notmasteryet/SatPointer/README.md

# SatPointer

Shows where the board is pointing, in the terms used to aim a satellite dish,
and tells you which way to turn to reach a target you dial in.

- **azimuth**: true bearing, 0° = north, 90° = east, measured clockwise
- **elevation**: angle above the horizon, from −90° to +90°
- **roll**: rotation around the pointing direction

The pointing direction is the beam, which is whichever device axis the
**beam mount** setting names — by default the +X arrow printed on the GY-521.

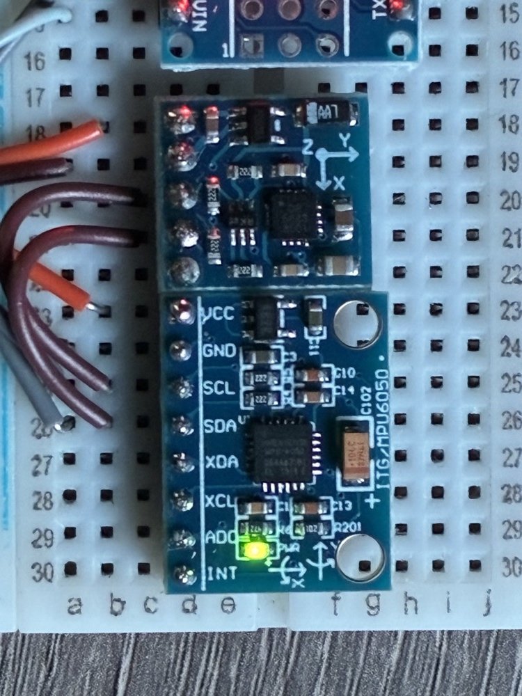
[picture p1: images/board.jpg]
board


Ported from the Arduino Nano sketch in `docs/original-nano/` to an
ESP-12F with an OLED and a rotary encoder. The sensor maths is unchanged.

## Hardware

| Part | Chip | I2C address |
|---|---|---|
| ESP-12F on a USB-UART adapter | ESP8266EX, 4MB flash | |
| GY-521 | MPU6050 (accelerometer) | 0x68 |
| GY-271 | QMC5883L (magnetometer) | 0x0D |
| 0.96" OLED | SSD1306 128×64 | 0x3C |
| EC11 rotary encoder + button | | |

All three I2C devices share one bus:

| Signal | ESP-12F |
|---|---|
| SDA | GPIO4 |
| SCL | GPIO5 |
| VCC | **3.3V** |
| GND | GND |

| Encoder | ESP-12F |
|---|---|
| A | GPIO13 |
| B | GPIO14 |
| button | GPIO0 |
| common (middle pin of the 3-pin side) | GND |

The quadrature section and the push switch have **separate grounds**. With the
common pin floating the button still works perfectly while the dial does
nothing at all, because the internal pullups hold A and B high and no edge ever
reaches the interrupt. Send `e` to check: if A and B do not change as you turn,
that is the cause. On a KY-040 breakout, its **+** pin must also be powered,
since its pullups are on the module.

**The ESP8266 is not 5V tolerant.** The original Nano wiring ran both sensor
modules from 5V; on this board they must be on 3.3V.

**GPIO0 is the boot strapping pin.** Holding the encoder button down through a
reset enters the flash bootloader instead of the app — which is convenient, it
doubles as a proper flash button, but it means the button must idle high.

Boot pins on the bare module: EN (CH_PD) → 3.3V, GPIO15 → GND, GPIO2 floating.
Use a 3.3V adapter that can source ~300mA peak; cheap breakouts brown out
mid-flash.

**Sensor mounting:** both sensor modules lie flat on the board, with the
GY-271's **Y** arrow pointing the same way as the GY-521's **X** arrow. That
relationship is fixed in `ACC_AXIS` / `MAG_AXIS` in `src/orientation.cpp`;
change it only if you rearrange the modules relative to each other.

**Beam mounting** — which way round the whole device clamps to the beam — is a
runtime setting, see below.

Some GY-271 boards carry an HMC5883L (0x1E) or a QMC5883P (0x2C) instead, which
this code does not support. The I2C scan printed at every boot names whichever
is fitted and flags anything unexpected on the bus.

## Beam mount

The beam points along one of four device axes. Press `m` to cycle; the current
one shows in the status row and in `p` output.

| Mount | Beam axis | Beam points out the device's |
|---|---|---|
| `top` | +X | top face (default) |
| `left` | +Y | left side |
| `right` | −Y | right side |
| `away` | −Z | back, away from the screen |

Axes are the board frame: X = the GY-521's printed +X arrow, Y = left, Z = up.

**This table was measured, not inferred.** Holding the device with its top face
at true north and the screen up, the `a` command reported +X north, +Y west, −Y
east and −Z straight down. An earlier version was worked out from how the board
looked and had three of the four entries wrong — if you rebuild the hardware,
re-measure it with `a` rather than reasoning about it.

**Changing the mount means recalibrating.** Hard/soft-iron correction is in
sensor frame and survives moving the sensor relative to itself, but clamping to
a different face of a metal beam changes the surrounding ferrous mass entirely.

## Build and flash

```sh
pio run -t upload                 # flash over serial (needs GPIO0 held low)
pio run -e ota -t upload          # flash over WiFi, no cable and no button
python3 tools/monitor.py          # serial capture (clears DTR; see below)
```

Once WiFi is configured, use the OTA target — serial flashing on this hardware
means holding the encoder button down through every upload.

Source layout:

| File | Holds |
|---|---|
| `main.cpp` | setup/loop, sample and draw scheduling |
| `config.h` | pins, addresses, timing constants |
| `sensors.*` | I2C bus, MPU6050 and QMC5883L reads, boot scan |
| `orientation.*` | mount table, frame remap, sensor fusion |
| `calibration.*` | magnetometer min/max calibration |
| `display.*` | SSD1306 rendering |
| `input.*` | encoder and button |
| `commands.*` | serial commands and the data line |
| `rotator.*` | declares the SatNOGS rotator's position from this aim |
| `settings.*` | the persisted `Settings` struct |

`upload_port` is pinned in `platformio.ini`. For a 0.91" panel change
`-D OLED_H=64` to `32`.

If an upload fails with `Timed out waiting for packet header`, hold the encoder
button (or ground GPIO0) while the board resets, upload, then release it.

## Use

The display has two screens, swapped from the menu under **Screen**.

The graphic one is the default: a compass seen from above and the same beam
seen from the side, each drawn as an arm with the device as a crossbar on it,
plus an arrowhead for which way to turn. The yellow strip along the top carries
how far to go, the current angles, and whether the calibration can be trusted.

`tools/simulate/run.sh` renders that screen on a host by compiling the real
`src/guidance.cpp` against a mock Adafruit_GFX. Use it when changing the
layout — the panel is two-colour, the top 16 rows being yellow and the rest
cyan with a gap between, so nothing may straddle row 16, and that is far easier
to check in a terminal than by flashing and squinting.

The numeric screen shows current and target angles, and what to do about the
difference:

```
AZ  90.2 -> 145.0
EL  -1.5 ->  28.5
--------------------
turn RIGHT     54.8
raise          30.0

[AZ]  el     cal ok
```

- **turn the encoder** to move the target
- **press** to switch between editing azimuth and elevation — the bracketed
  label shows which is live
- **hold** for 0.8s to open the menu

## Menu

Hold the button to open it, turn to choose, press to activate, hold to go back.

| Item | Does |
|---|---|
| Rotor north | tells the SatNOGS rotator where its antenna points — see below |
| Mount | pick the beam mount; turn to preview, press to apply, hold to cancel |
| WiFi | shows link state and address; press toggles the radio |
| Screen | graphic or numbers |
| Clear target | zeroes both targets |
| Calibrate | starts magnetometer calibration — press to save, hold to abandon. The verdict (OK / POOR / FAILED, with the score) shows on screen afterwards. |
| Exit | back to the guidance screen |

Five items fit on the panel; the list scrolls to follow the selection.

### Rotor north

Clamp the device to the antenna boom on the SatNOGS rotator, open **Rotor
north**, and press. It connects to `satnogs-rotor1:23` (esp-link's serial
bridge, `ROTATOR_HOST` in `config.h`) and does what `sattrack.py deploy` does,
with the pointer's reading standing in for sighting the sun:

```
M114                       what the rotator thought before, shown as "was"
M503, M564 E               which way its E axis is set; flipped if it does not match
G92 A<az> E<-el>           this is where the antenna points
M208 S1 A<az-360> ...      travel re-centred a turn either way
M208 S0 A<az+360> ...
M500                       saved
M114                       confirmed: Ref:11 and A took
```

**Turn the dial to pick the antenna side, CW or CCW.** The antenna can be
bolted to either end of the elevation shaft, and on the far end it faces the
other way, so the same rotation lowers it instead of raising it. CW is the
side the rotator was built for (`M562 E1`). CCW makes Rotor north send
`M564 E`, which inverts the rotator's E axis and is saved by the `M500`, but
only when the rotator is set for the other side. Negative E then means up on
either side, so `tracker/config.json`'s `el_sign` stays −1. The 180° of
azimuth that come with the far side need nothing, because the declaration is
the pointer's reading of where the antenna really points.

Nothing moves, and the motors stay as they were. Elevation is declared too,
since one aim pins both and the accelerometer's elevation is the reading to
trust. `E` is sky elevation times −1, the build's `el_sign`.

- The declared A is the bearing's equivalent nearest the rotator's current
  count (−21, not 339), so "go north" afterwards is the short way round.
- **Have the cable wrap neutral first.** The travel fence is a wrap budget
  around the declared position, as `deploy` treats it.
- **Don't run `sattrack.py` at the same time.** esp-link sends every reply to
  every connection.
- Azimuth is only as good as the calibration, so the screen shows the grade
  before you press. Calibrate with the device on the boom, since the antenna's
  metal moves with it.

The mount picker previews without committing, so turning past the one you want
costs nothing. Applying a mount resets the sensor filter and warns that the
magnetometer calibration no longer holds.

Calibration is the same whether started from the menu or by sending `c`, so
either can finish it.

The target is saved to EEPROM two seconds after you stop turning, so a sweep of
the dial costs one flash write rather than one per detent.

Serial at **115200** prints 10 lines per second, as `label:value` pairs so the
Serial Plotter can graph them:

```
elev:-1.5 az:90.2 daz:54.8 del:30.0 roll:0.8 dip:65.3 B:52.1
```

| Field | Meaning |
|---|---|
| `elev` | elevation of the beam |
| `az` | true azimuth of the beam |
| `daz` | degrees to turn to reach the target; positive = clockwise |
| `del` | degrees to raise to reach the target |
| `roll` | rotation around the beam; positive when the right side is down. This is dish skew. |
| `dip` | magnetic dip angle. Should hold constant while the device is still; if it moves when it is not being handled, the axis mapping is off. |
| `B` | field strength in µT. Earth's is 25–65; much more means something magnetic is nearby. |

## Network

On first boot with no stored credentials the device brings up an open access
point, **SatPointer-setup**. Join it, open any address in a browser, and enter
your network and password; it saves them and reboots. Or set them over serial
with `w<ssid> <password>`.

Once joined it is `satpointer.local`, and `pio run -e ota -t upload` flashes it
wirelessly. If the stored credentials stop working it falls back to the setup
AP rather than retrying forever — otherwise there would be no way to correct
them without a cable.

The radio can be switched off from the menu, or with `W` over serial.
**Measured 2026-09-24, it does not need to be:** field noise with the radio
off, idle, and under load was sd 0.091, 0.094 and 0.090 uT, with azimuth sd
0.54–0.55 throughout — no detectable interference. The toggle stays because
that result is specific to this layout; re-measure with `W` if the
magnetometer moves closer to the module.

OTA has no password, so anyone on the network can reflash the device. That is
usually fine on a home LAN; if it is not, set one with
`ArduinoOTA.setPassword()` in `src/net.cpp` and add `upload_flags` to the `ota`
environment.

## gpredict

The device emulates hamlib's **rotctld on TCP 4533**, which gpredict drives
natively. You are the rotator: gpredict sends where to point, reads back where
the device actually points, and you turn the dish by hand following the
display. A `NET` marker appears on screen while it is driving, so the targets
moving on their own is not alarming.

In gpredict, add a rotator with host `satpointer.local` and port `4533`.

| Command | Reply |
|---|---|
| `p` / `\get_pos` | azimuth and elevation, one per line |
| `P az el` / `\set_pos az el` | `RPRT 0` |
| `S` stop, `K` park | `RPRT 0` — nothing to stop, but refusing would look like a fault |
| `_` | `SatPointer` |
| anything else | `RPRT -1`, and logged to serial |

Targets set over the network are **not** written to flash. gpredict sends `P`
about once a second for the length of a pass, which through the encoder's save
path would be thousands of flash writes.

### Radio frequency — rigctld on TCP 4532

It also emulates **rigctld on TCP 4532**, where gpredict's radio controller
connects, so the frequency gpredict tunes to, Doppler included, is shown on the
display. There is no radio behind it. In gpredict, add a radio with host
`satpointer.local` and port `4532`.

The frequency takes the top-right slot that otherwise shows calibration status
(bottom-right on the numbers screen), in MHz with as many decimals as fit:
trailing zeros dropped: `145.89`, `145.8123`, `10489.55`. It is the main VFO (VFO A), which is the downlink in
every gpredict mode except a TX-only radio. It clears when gpredict disconnects.

`F`/`f` frequency, `V`/`v` VFO, `I`/`i` split TX frequency, `S`/`s` split,
`M`/`m` mode, `T`/`t` PTT (always off), `\get_dcd`, `\chk_vfo`, with their long
forms. Reads return what was set, which is what gpredict checks to tell whether
the knob was turned. Anything else is answered `RPRT -1` and logged to serial
as `# rigctl: unhandled '...'`. `/status` shows the current frequency.

## Config page

`http://satpointer.local` is where the fiddly settings live, rather than on a
128x64 panel behind one knob. Live azimuth and elevation with which way to
turn, the target, beam mount, azimuth trim, calibration with live coverage bars
and its graded verdict, WiFi credentials, radio toggle, and erase.

The device keeps the target dial and the guidance screen; the browser gets
everything else. Serial commands still work and are the fallback when there is
no network.

Two other endpoints: `/status` is plain text for shells and scripts, `/api` is
JSON and is what the page polls.

## Calibration (do once)

The magnetometer needs calibrating, because the module headers and anything
steel nearby bend the magnetic field. Do it with everything mounted exactly as
it will be used. Until it is done the display shows **NO CAL** and azimuth
should not be trusted.

1. **Magnetometer:** menu → Calibrate (or send `c`), slowly rotate the board
   through *every* orientation for 30–60 seconds including upside down, then
   press (or send `c` again). The display shows the swing collected on each
   axis and the sample count while this runs.

   **Calibrate in the exact final configuration, cables included.** Hard-iron
   offsets belong to the surrounding metal, so a calibration done with the UART
   unplugged does not transfer to running with it plugged in.

   The result is graded, not assumed. The device applies the fit back to the
   samples it kept and measures how constant the corrected field magnitude
   comes out; Earth's field is locally constant, so any remaining variation is
   fit error. Under 3% standard deviation counts as calibrated and the status
   slot reads `ok N%`; above it reads `BAD N%` and azimuth is not trusted.

   |B| is used rather than dip because dip also needs the accelerometer's idea
   of down, so handling acceleration corrupts it and it cannot tell a bad fit
   from someone waving the device about.
2. **North:** point the beam at a known true bearing and send it. `n90`
   means it points east, `n` means north. This also absorbs magnetic
   declination.

Both are saved to EEPROM and survive a restart.

| Command | Action |
|---|---|
| `c` | start / finish magnetometer calibration |
| `x` | abandon a calibration in progress |
| `nDEG` | the beam is currently pointing at true bearing DEG |
| `m` | cycle the beam mount (top / left / right / down) |
| `r` | switch raw sensor output on or off |
| `e` | print encoder pin states, for the wiring check above |
| `a` | print where every board axis is pointing, for filling in the mount table |
| `w<ssid> <pass>` | store WiFi credentials |
| `p` | print stored settings |
| `z` | erase settings |
| `h` | help |

## How it works

At rest, the accelerometer tells which way is down (**D**), and the
magnetometer gives the magnetic field (**M**). From those two vectors:

- **East** = D × M
- **North** = East × D

Taking the beam's components along north, east and down gives azimuth
`atan2(E, N)` and elevation `asin(−D)`. This works however the board is tilted.
Both sensor vectors are smoothed with a simple low-pass filter.

## Status

Verified on hardware 2026-09-22: both sensors read (field 46 µT, well inside
Earth's range), EEPROM load/store works, the encoder counts and its target
persists, and the button toggles the edited axis cleanly.

Phase-1 refactor and beam mount verified on hardware 2026-09-23: all four
mounts produce the angles geometry requires (beam reversed flips elevation and
swings azimuth 180°, the side face reads ~0° elevation and 90° round, the
bottom face reads 90° below the front), cycling returns to the start value, and
dip and field strength — both rotation invariants — hold constant across all
four, so the remap does not corrupt the magnetic vector.

Not yet verified:

- **Encoder direction.** Counting works, but which way clockwise moves the
  target was never confirmed. If it is inverted, swap `PIN_ENC_A` and
  `PIN_ENC_B`.
- **The OLED rendering.** It enumerates at 0x3C and `display.begin()` succeeds,
  but nobody has confirmed the layout looks right on the panel.
- **Calibration quality.** Grading works on real hardware, but no calibration
  has passed it yet: two attempts scored sd 4.56% and 4.4% against a 3%
  threshold, so the status slot reads `BAD 4%` and azimuth is not trusted.
  Landing twice in the same place suggests the min/max model is the limit
  rather than the rotation — see the ellipsoid note in `docs/ROADMAP.md`.

## Limitations

- Azimuth isn't meaningful when +X points nearly straight up or down.
- Readings are only correct while the board is still or moving slowly. Shaking
  adds acceleration on top of gravity, which throws off the accelerometer. A
  gyro filter would fix that; the MPU6050 has a gyro, but this code doesn't use
  it yet.
- Recalibrate if you add or move anything metal or magnetic near the GY-271.

## Serial capture quirk

**Set `dtr = False` before reading, or the port goes silent.** Opening the port
with pyserial's defaults produced zero bytes at 115200 while the ROM bootloader
was visible at 74880 — i.e. the chip sat in flash mode instead of running the
app. Clearing DTR fixed it every time. `tools/monitor.py` does this; use it
rather than a bare `pio device monitor`, which also never exits on its own and
macOS has no `timeout` command to stop it.

Pulsing RTS does **not** reset this board — uptime kept climbing straight
through the attempts — so the boot banner can only be caught right after an
upload, or by resetting the board by hand. What is actually wired to DTR/RTS on
this adapter has not been established; the above is the observed behaviour, not
a schematic.

Boot output starts with garbage: the ROM bootloader talks at 74880 baud before
the sketch's 115200 banner. That's expected.
