notmasteryet/SatPointer/docs/ROADMAP.md

# SatPointer roadmap

Hardware POC is done (see the Status section of the main README). This is the
software we want next, and the decisions already made about it.

## 1. Mount orientation — DONE 2026-09-23 (built, not yet run on hardware)

The device clamps to the beam in one of four ways. Was hardcoded to forward
(+X); now a runtime setting cycled with `m`, stored in `Settings.mount`.

Four options, spanning all three board axes, with X used both ways for
convenience:

| Name | Beam axis | Device orientation |
|---|---|---|
| `top` | +Y | beam out the left face |
| `down` | −Z | beam out the bottom, screen faces up |
| `left` | −X | beam out the back |
| `right` | +X | beam out the front (today's default) |

Axes are the **board frame** the code already defines — X = the GY-521's
printed +X arrow, Y = left, Z = up — not raw chip axes; the GY-271 is already
remapped onto that frame.

**As built:** `toCanonical()` in `src/orientation.cpp` rotates the sensor
vectors into a frame where the beam is +X, so `orientationAngles()` runs
unchanged with the beam still `(1,0,0)`. The fusion maths was not touched.
Verified on the host: every mount maps its beam axis onto canonical +X with a
right-handed frame, and `right` is the exact identity, so the orientation the
POC ran in behaves bit-for-bit as before.

Changing mount calls `orientationReset()` — the low-pass filter holds vectors
in the old frame and blending across the change would drift through nonsense.

**Still open:** the `up` column. The beam axis fixes azimuth and elevation, but roll
needs a second reference, and roll is dish skew. The values above are merely
perpendicular to the beam — they will produce a roll number, not necessarily
zero when the dish is level. Likely answer is a per-mount roll offset zeroed in
the field with the beam level, same pattern as the existing `n` bearing trim,
which also absorbs clamp slop no table can predict.

**Couples to calibration:** hard/soft-iron correction is in sensor frame, so it
survives moving the sensor relative to itself — but moving to a different face
of a metal beam changes the surrounding ferrous mass entirely. Changing mount prints a recalibration warning; storing a
profile per mount is still to do.

## 2. Calibration

The min/max hard-iron fit plus crude scale needs a real quality signal. The
symptom is already visible: `dip` swings 59°–75° with tilt when it should hold
constant.

- **Use |B| variance as the primary quality metric, not dip.** Measured
  2026-09-23: waving the device through 135° of elevation and a full turn of
  roll gave dip a 20° spread but |B| an 11% spread. Dip is computed from the
  magnetic vector *and* the accelerometer's idea of down, so handling
  acceleration corrupts it — it conflates magnetometer error with motion. |B|
  is just the corrected field magnitude and touches no other sensor, so it
  isolates the hard/soft-iron fit. Earth's field is locally constant, so any
  variation is calibration error or interference.
- Keep dip as a secondary check, evaluated only while still: it is the thing
  that catches an accelerometer/magnetometer axis-mapping mistake, which |B|
  alone cannot see.
- Keep the per-axis coverage bars; add a pass/fail on |B| stability at the end.
- **An ellipsoid fit is probably now required, not optional.** Two graded
  attempts on 2026-09-23 scored sd 4.56% and 4.4% against a 3% threshold.
  Landing twice in the same place is a plateau rather than scatter, which
  points at the model rather than the rotation: min/max fits a diagonal
  correction only, so it cannot represent cross-axis soft iron. Simulated
  cross-axis distortion scores 5.4% — the same order as what the hardware is
  producing. A third careful attempt would confirm it before spending the code;
  if it lands near 4.5% again, stop rotating and fit an ellipsoid.
- **Calibrate in the exact final configuration, cables included.** The first
  real calibration was done with the UART unplugged (a tether fights the
  rotation) and then measured with it plugged in; hard-iron offsets are
  specific to the surrounding metal and do not transfer. A dish reflector is a
  much larger distorting mass again.

## 3. WiFi, mDNS, NTP, OTA — DONE 2026-09-24

- **OTA belongs in this phase**, not later. `ArduinoOTA` removes the manual
  GPIO0 flash-mode step, which has been the single biggest time sink so far.
- AP-fallback credential portal rather than a hardcoded SSID, so changing
  networks does not mean reflashing.
- mDNS → `satpointer.local`.
- **NTP is optional.** gpredict does the orbital maths on the PC. Time only
  earns its place if onboard pass prediction happens later — defer it.

Two hardware risks were expected to gate this phase. **Neither materialised**,
measured 2026-09-24 on the existing USB-UART supply:

- **Power.** No brownout joining the network, and none through a ~15 s OTA,
  which is the heaviest sustained transmit the device does. The supply was not
  changed. Revisit if the device is ever battery powered or the adapter
  changes.
- **Magnetometer interference.** Not detectable. Field noise with the radio on,
  off, and under 1400-byte traffic at 10/s: sd 0.094, 0.091 and 0.090 uT, with
  azimuth sd 0.55, 0.54, 0.54. The differences are inside the noise floor, and
  the quietest run was a radio-on one. So WiFi can stay on while aiming.

  This holds for the current geometry only. If the magnetometer moves closer to
  the module or the supply wiring changes, re-measure — the `W` command toggles
  the radio over serial so the test needs no hands near the sensor.

## 4. gpredict support — rotctld on TCP 4533 — DONE 2026-09-24

Emulate hamlib's rotctld, which gpredict drives natively. You are the rotator;
you turn the dish by hand following the display.

```
> P 145.0 28.5      set target      < RPRT 0
> p                 read position   < 90.2
                                    < -1.5
> S                 stop            < RPRT 0
> q                 quit
```

Non-blocking, one client, parsed line by line.

**The flash-wear trap, handled:** the encoder persists its target 2 s after it
changes, and gpredict sends `P` continuously while tracking a pass. Network
targets therefore bypass that path entirely. Verified on hardware: 47 position
sets and 47 reads over 25 s produced zero flash writes.

Also implemented: `S` and `K` answer `RPRT 0` rather than refusing — there is
nothing to stop when a human is the drive train, but refusing would make
gpredict think the rotator is broken. Unhandled commands answer `RPRT -1` and
are logged, so the first real gpredict session reports anything still missing.

Not yet done: tested against a synthetic client speaking the protocol, **not
against gpredict itself.**

## 5. Guidance graphics — DONE 2026-09-24

Two line-drawn views of the same beam: a compass from above and the same arm
from the side, each with the device as a crossbar on it and an arrowhead for
which way to turn. Line-drawn, not bitmap, since Adafruit_GFX cannot rotate
bitmaps.

**The panel is two-colour** — top 16 rows yellow, the remaining 48 cyan, with a
physical gap between them. Nothing may straddle that line, so the yellow strip
is the header (how far to go, current angles, cal state) and the two views sit
side by side in the cyan band below. This was found by being told, after a
first layout had the compass straddling the boundary.

Built against `Adafruit_GFX` and rendered on the host by `tools/simulate`,
which compiles the shipping source against a mock. That caught two layout bugs
before any flash: a baseline elevation pivot that drew off the panel for any
negative elevation, and the north label touching the compass rim. **Worth
keeping — nobody working on this can see the screen.**

The bullseye idea was dropped: with a compass and a side view there is no room,
and those two say the same thing more literally.

Still not done: **roll as a target.** Roll is dish skew, the LNB polarisation
angle, and is still only a diagnostic. It needs the per-mount up reference from
section 1 before a roll target would mean anything.

## 6. HTTP config page — DONE 2026-09-24

Splits the UI properly: **OLED for field guidance, browser for setup.** Keeps
the encoder doing one job instead of growing a menu tree on a 128×64 panel.

- **In-core `ESP8266WebServer`, not ESPAsyncWebServer.** Plenty for a config
  page, one less dependency; it blocks a few ms per request, which the 50 Hz
  sample loop absorbs.
- **Embed the page in PROGMEM, not LittleFS.** A few KB of HTML means one
  firmware image and no separate filesystem upload step.

In the browser: live readout, target, mount, azimuth trim, calibration with
live coverage bars and the graded verdict, WiFi credentials, radio toggle and
erase. On the device: the target dial and the guidance screen. Serial commands
stay as the no-WiFi fallback, and `/status` serves plain text for shells.

Not done here: **the roll offset**, because which direction is "up" for each
mount is still the open question from section 1, and a field to type a number
into does not answer it. Target presets were not built either — nothing has
asked for more than one target yet.

The page is ~6 KB in PROGMEM and one firmware image, as planned. HTTP handlers
live in `web.cpp`; `net.cpp` kept only the job of getting and staying on the
network.

## Cross-cutting

- ~~Split `satpointer.cpp` before WiFi lands~~ — done 2026-09-23. Now
  config / sensors / orientation / calibration / display / input / commands /
  settings, with `main.cpp` holding only the loop scheduling.
- **Settings outgrow the EEPROM struct.** The magic number already needed one
  bump. JSON in flash is more forgiving to schema changes and maps directly
  onto the config form.

## Sequencing

1. ~~Refactor~~, ~~mount orientation~~, ~~calibration grading~~ — done
2. ~~WiFi + OTA~~ — done; the supply needed no work after all
3. ~~rotctld~~ — done, pending a test against real gpredict
4. ~~HTTP config page~~ — done
5. ~~Guidance graphics~~ — done
6. Ellipsoid calibration fit — **deprioritised 2026-09-23**

The ellipsoid fit was the natural continuation of phase 1, but it is a
refinement of something that already works well enough to use: calibration
scores ~4.5% and the device says so rather than pretending otherwise, so
azimuth is usable with a known caveat instead of silently wrong. Features come
first. Pick it up when azimuth accuracy is the thing actually blocking a real
aiming job.
