notmasteryet/SatPointer/(commit log)

2026-09-24 Port elev_azimuth from Arduino Nano to ESP-12F
    Moves the Nano sketch into a PlatformIO project targeting a bare ESP-12F,
    adds an SSD1306 OLED and a rotary encoder, and keeps the hardware smoke
    tests as sibling build environments.
    The sensor fusion maths is carried over unchanged. Platform differences
    that needed real changes:
    - ESP8266 EEPROM is a RAM shadow of a flash sector, so it needs begin()
    and commit(); the AVR version wrote directly and calibration would have
    silently never persisted.
    - Wire.setWireTimeout() does not exist in this core; the MPU6050 stretches
    the clock, so setClockStretchLimit() replaces it.
    - This core's Stream predates parseFloat(LookaheadMode).
    - Interrupt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
    [elev_azimuth.ino, i2c_probe.ino, monitor.py]
2026-09-24 Split firmware into modules and make the beam mount a setting
    Phase 1 of docs/ROADMAP.md.
    satpointer.cpp becomes config / sensors / orientation / calibration /
    display / input / commands / settings, with main.cpp holding only the
    loop scheduling. Doing this before WiFi lands rather than after, since
    that is what doubles the size.
    The beam no longer has to point along +X. A mount table names four ways
    of clamping the device to the beam - top (+Y), left (-X), right (+X),
    down (-Z) - and toCanonical() rotates the sensor vectors into a frame
    where the beam is +X before fusion runs. orientationAngles() is
    unchanged as a result, and "right" is the exact identity, so the
    orientation the POC was v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
    [calibration.cpp, calibration.h, commands.cpp, commands.h, config.h, display.cpp, display.h, input.cpp]
2026-09-24 Verify the beam mount table on hardware
    All four mounts produce the angles geometry requires, taking "right"
    (+X, 25.0 elev / 192.0 az) as the reference pose:
    left (-X) predicted -25 / 12 observed -23.4 / 14.6
    top (+Y) predicted ~0 / 103 observed -4.9 / 106.6
    down (-Z) predicted -65 / ~193 observed -64.2 / 208.7
    Cycling all the way round returns to the start value, so the table has
    no ordering error. down's azimuth is 16 degrees off because roll drifted
    5 to 13 degrees while the device was held, and azimuth is very sensitive
    to pose with the beam at -64 elevation - the documented near-vertical
    limitation appearing where it should.
    Dip held 57.6-58.3 and field 50.9-51.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
2026-09-24 Add a button-held menu for calibration and mount
    Calibration and mount selection needed a laptop before this; both are now
    reachable from the device alone. Holding the button opens a menu - turn
    to choose, press to activate, hold to go back.
    Holding used to clear the target. That was a weak use of the only
    gesture available, and clearing is now a menu item instead.
    input.cpp no longer acts on what it reads. It reports detents and
    short/long press events, and ui.cpp decides what they mean in the
    current mode, so there is one place that knows the modes rather than the
    knowledge being spread across input and display. The long press fires
    while the button is still held rather than on release,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
    [calibration.cpp, calibration.h, commands.cpp, display.cpp, input.cpp, input.h, main.cpp, ui.cpp]
2026-09-24 Prefer |B| over dip as the calibration quality metric
    Measured on hardware: moving the device through 135 degrees of
    elevation and a full turn of roll gave dip a 20 degree spread but |B| an
    11% spread.
    Dip is computed from the magnetic vector and the accelerometer's idea of
    down, so handling acceleration corrupts it - it cannot distinguish
    magnetometer error from motion. |B| is the corrected field magnitude
    alone, touches no other sensor, and Earth's field is locally constant,
    so its variation is calibration error or interference and nothing else.
    Dip stays useful as a secondary check while still, because it catches an
    accel/mag axis-mapping mistake that |B| cannot see.
    Also records why th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
2026-09-24 Grade the magnetometer calibration instead of assuming it worked
    magCal was set unconditionally, so the display claimed "cal ok" for the
    one real calibration run so far - which turned out to be visibly
    unreliable. Now the fit is applied back to the samples and scored.
    Earth's field is locally constant, so a good fit maps the samples onto a
    sphere and corrected |B| comes out constant; whatever variation remains
    is fit error. |B| rather than dip because dip also needs the
    accelerometer's idea of down, so handling acceleration corrupts it and
    it cannot separate a bad fit from someone waving the device about.
    Scoring uses standard deviation, not peak-to-peak. Simulation showed
    peak-to-peak is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
    [calibration.cpp, calibration.h, display.cpp, settings.cpp, settings.h]
2026-09-24 Fix settings magic that was never bumped, and show the verdict on screen
    Adding calField and calSpread to Settings was supposed to bump the magic
    to 0xCA1F. The edit that did so silently matched nothing and the build
    succeeded anyway, so the magic stayed 0xCA1E and the old EEPROM contents
    were accepted at the new field offsets:
    calField <- old targetAz read 0.0
    calSpread <- old targetEl read 0.0
    targetAz <- old mount byte and padding -> NaN
    targetEl <- whatever followed -> NaN
    NaN targets then propagated into daz and del, and the stale magCal made
    the device report a previous calibration as current.
    Three fixes. The magic is now 0xCA1F. Settings are sanity checked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
    [calibration.cpp, calibration.h, display.cpp, settings.cpp, ui.cpp]
2026-09-24 Measure the mount table instead of inferring it, rename down to away
    Reported symptom: with the mount set to "right", azimuth read zero when
    the device's top face pointed north. The table said "right" was beam +X,
    so +X was physically the top, not the right - the mapping we derived
    from how the board looks did not match the hardware.
    Added an 'a' command that reports where every board axis is currently
    pointing, so the table can be filled in by measurement. Held with the
    top face north and the screen up it gave +X north, +Y west, -Y east, +Z
    up, -Z down, with the horizontal axes exactly 90 degrees apart.
    That makes the mapping top +X, left +Y, right -Y, away -Z. Three of the
    four previous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
2026-09-24 Record the calibration plateau at ~4.5%
    Two graded attempts scored sd 4.56% and 4.4% against a 3% threshold.
    Landing twice in the same place is a plateau rather than scatter, which
    points at the model and not the rotation: min/max fits a diagonal
    correction only and cannot represent cross-axis soft iron. Simulated
    cross-axis distortion scores 5.4%, the same order as the hardware is
    producing.
    So the ellipsoid fit moves from optional to probably required. A third
    careful attempt would confirm before spending the code.
2026-09-24 Deprioritise the ellipsoid fit behind the feature work
    The ellipsoid fit was the natural continuation of phase 1, but it
    refines something that already works well enough to use: calibration
    scores around 4.5% and the device reports that rather than pretending
    otherwise, so azimuth is usable with a known caveat instead of silently
    wrong.
    Next is phase 2 - power supply, then WiFi and OTA.
2026-09-24 Add WiFi, mDNS and OTA updates
    OTA is the point of this as much as the network is. Flashing over serial
    needs GPIO0 held low through a reset, which on this hardware means
    physically holding the encoder button for every single upload - about a
    dozen times in the last session alone. "pio run -e ota -t upload" now
    does it over the air.
    No credentials means an open AP called SatPointer-setup serving a small
    embedded form; saving reboots into the network. Credentials that stop
    working fall back to the same AP rather than retrying forever, because
    otherwise there is no way to correct them without a cable. The page is
    in PROGMEM rather than a filesystem so this stays one firmware image
    with no sep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
    [commands.cpp, display.cpp, main.cpp, net.cpp, net.h, settings.cpp, settings.h]
2026-09-24 Fix credentials being wiped on every boot
    The setup AP saved the network and rebooted, but the device came back
    with ssid '' and returned to the AP.
    The sanity check added with the WiFi fields required the last byte of
    each credential buffer to be NUL. strlcpy only guarantees a terminator
    somewhere within the buffer and leaves the bytes after it alone, so the
    tail held whatever the previous EEPROM layout had there. The check
    therefore failed for every valid credential and settingsBegin() reset
    the settings on each boot. It said so on serial, which is exactly where
    nobody is looking when they have just configured the device over WiFi.
    The check now tests that a terminator exists at all, and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
    [net.cpp, settings.cpp]
2026-09-24 Add a serial radio toggle; record that neither WiFi risk materialised
    The roadmap gated WiFi on a power supply fix and warned of magnetometer
    interference. Measured on hardware, neither is real here.
    Power: no brownout joining the network, and none through a 15 second
    OTA, which is the heaviest sustained transmit the device does. The
    supply was never changed.
    Interference: not detectable. Field noise with the radio off, idle, and
    under 1400-byte traffic at 10 per second came out at sd 0.091, 0.094 and
    0.090 uT, with azimuth sd 0.54 to 0.55 throughout. The differences are
    inside the noise floor and the quietest of the three runs was a
    radio-on one. WiFi can stay on while aiming.
    Adds a 'W'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
    [commands.cpp]
2026-09-24 Add rotctld emulation for gpredict, and an HTTP status endpoint
    Listens on TCP 4533 speaking hamlib's rotctld protocol, which gpredict
    drives natively. The device is the rotator and a human is the drive
    train: gpredict sends where to point, reads back where the device
    actually points, and the display says which way to turn. A NET marker
    appears while it is driving, because targets moving on their own is
    alarming otherwise.
    Network targets bypass the encoder's save path entirely. gpredict sends
    P about once a second for the length of a pass and the encoder persists
    its target two seconds after it stops changing, so routing the two
    together would be thousands of flash writes per pass. Verifie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
2026-09-24 Add the HTTP config page
    Everything fiddly moves to the browser: live readout with turn guidance,
    target, beam mount, azimuth trim, calibration with live coverage bars
    and its graded verdict, WiFi credentials, radio toggle and erase. The
    device keeps the target dial and the guidance screen, which is the split
    that stops a 128x64 panel behind one knob from growing a menu tree.
    About 6KB of HTML in PROGMEM, so still one firmware image with no
    filesystem upload - the thing that matters when the point is to stop
    needing the serial cable.
    HTTP handlers move to web.cpp. net.cpp had started to grow a user
    interface and its job is getting and staying on the network.
    A target typed on the page per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
2026-09-25 Add the graphic guidance screen, and a host renderer for it
    Two line-drawn views of the same beam: a compass from above and the same
    arm from the side, each with the device drawn as a crossbar on it and an
    arrowhead for which way to turn. Line-drawn because Adafruit_GFX cannot
    rotate bitmaps.
    The panel is two-colour - top 16 rows yellow, the other 48 cyan, with a
    physical gap between them - so nothing may straddle row 16. The yellow
    strip is the header and the two views sit side by side in the cyan band.
    The first layout had the compass straddling that boundary.
    drawGuidance takes a plain struct and an Adafruit_GFX rather than
    reading globals, so tools/simulate can compile the shipping sou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
2026-10-02 Send the rotctl position reply in one write
    gpredict reads the get_pos reply with a single recv() and showed ERROR on
    Engage when the azimuth and elevation lines arrived in separate packets,
    which the four separate prints produced with Nagle disabled.
    [rotctl.cpp]
2026-10-02 Add rigctld emulation and show gpredict's radio frequency
    gpredict's radio controller connects to TCP 4532. The frequency it sets,
    Doppler included, takes the calibration status slot on both screens,
    drawn inverted, in MHz with trailing zeros dropped. Both VFOs and the
    split TX frequency are remembered so reads return what was set.
    rotctl and rigctl now share LineServer, which sends every reply in one
    write: gpredict reads each reply with a single recv().
    The simulator's GFX mock now honours colour, so inverted text renders.
    [display.cpp, guidance.cpp, guidance.h, lineserver.cpp, lineserver.h, main.cpp, rigctl.cpp, rigctl.h]
2026-10-05 Add Rotor north: set the SatNOGS rotator's reference from the pointer
    A menu item that connects to the rotator through esp-link's serial bridge
    (satnogs-rotor1:23) and runs the same sequence as sattrack.py deploy, with
    the pointer's az/el in place of sighting the sun: G92, travel re-centred a
    turn either way, M500, then M114 to confirm. Nothing moves.
    The declared A is the bearing's equivalent nearest the rotator's current
    count, so an aim 21 degrees west becomes A-21 rather than A339 and going
    north afterwards is the short way round.
    The dial picks the antenna side, CW (as built) or CCW. On the far end of
    the elevation shaft the same rotation lowers the antenna, so CCW sends
    M564 E when t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
    [config.h, display.cpp, main.cpp, rotator.cpp, rotator.h, ui.cpp, ui.h]
